technoblogy/i2c-sd-card-module/README.md

# I2C SD-Card Module

An SD-card module based on an ATtiny1614 that allows you to write to and read from files on an SD card using a two-wire I2C interface.

For more information see [I2C SD-Card Module](http://www.technoblogy.com/show?3XEP).
