technoblogy/i2c-sd-card-module/Eagle files/I2CSDCardModule.brd

## EAGLE design Eagle files/I2CSDCardModule.brd (2022-07-14)

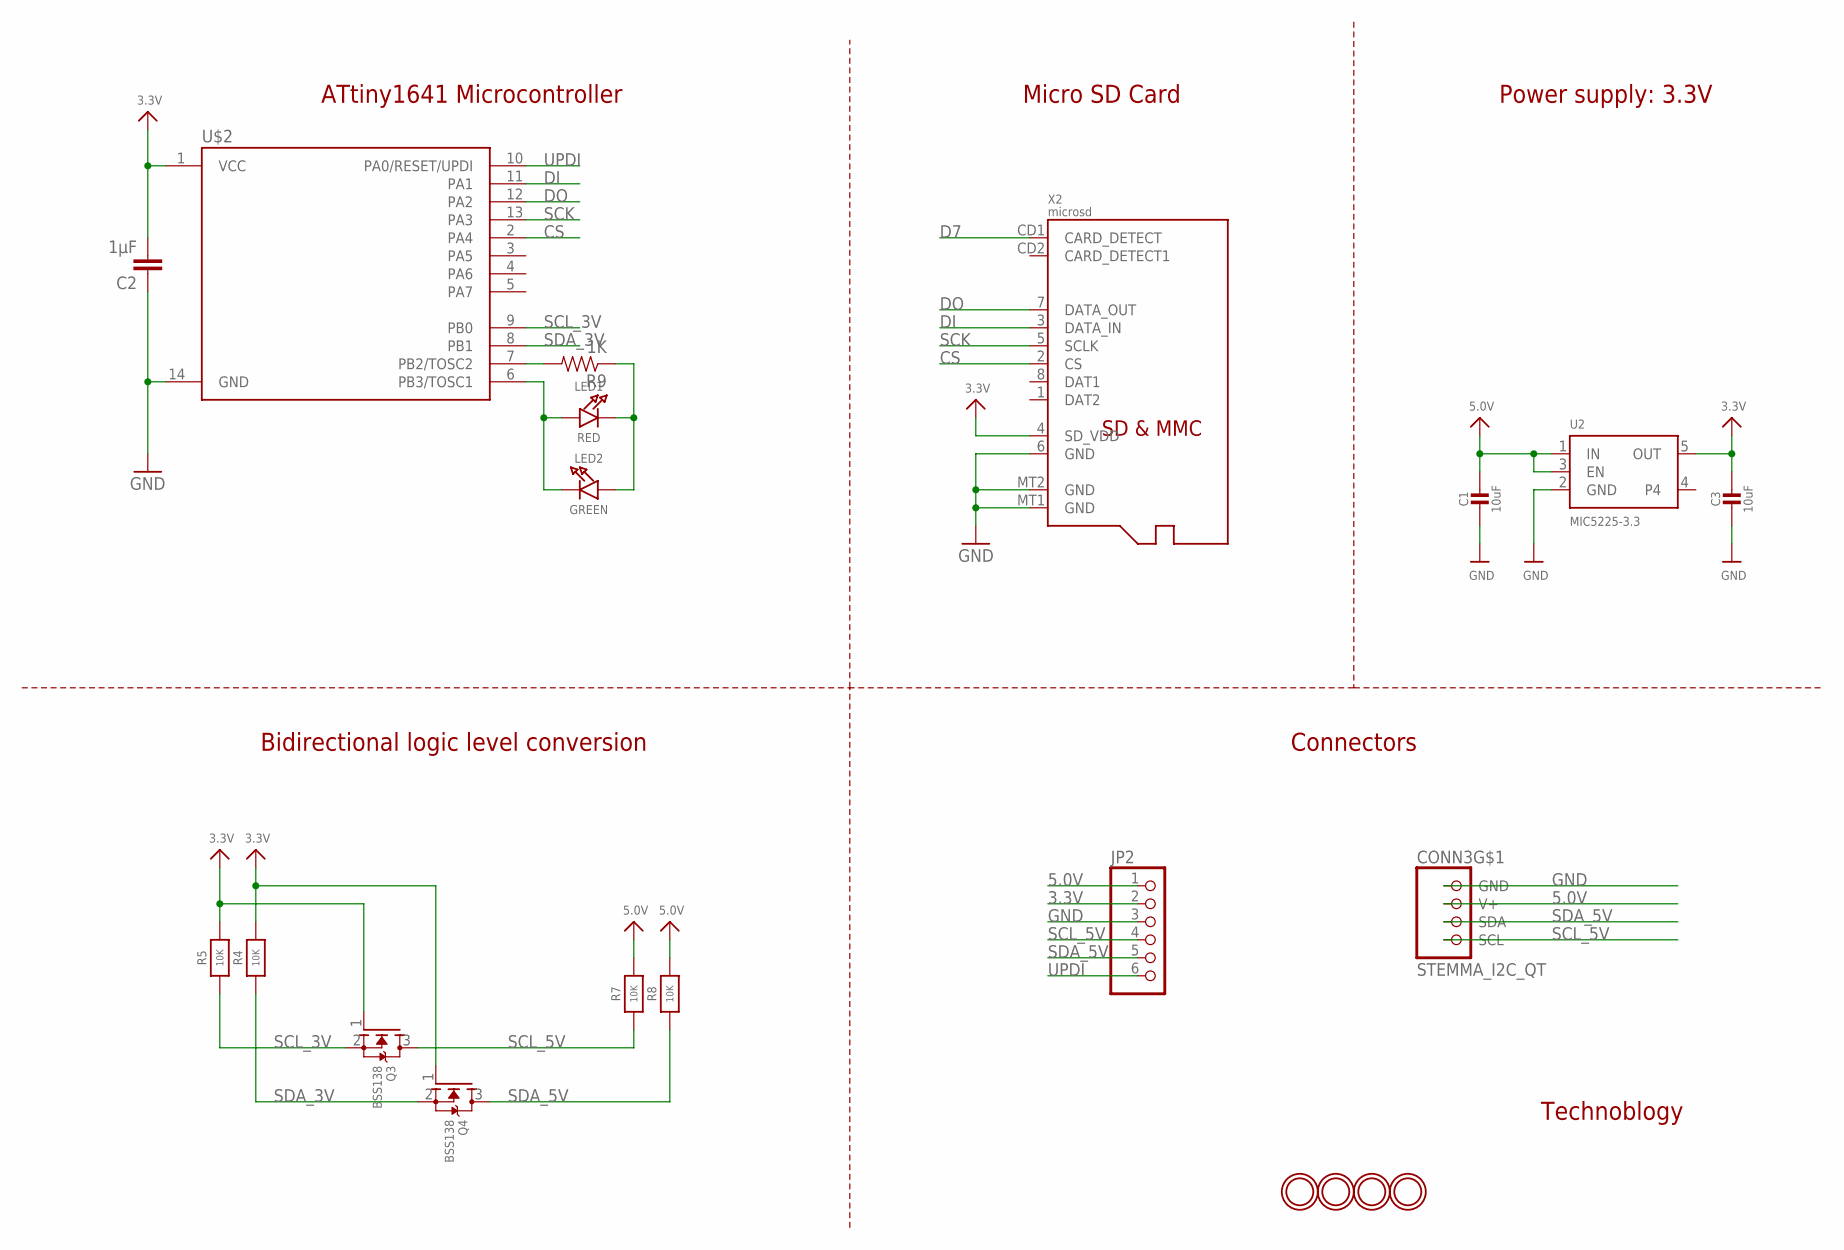
[picture p1: schematic I2CSDCardModule.sch]

Parts:
C1, C3: 10uF; 0805-NO
C2: 1µF; 0805
CONN3: STEMMA_I2C_QT; JST_SH4
JP2: HEADER-1X6ROUND; 1X06_ROUND
LED1: RED; CHIPLED_0805_NOOUTLINE
LED2: GREEN; CHIPLED_0805_NOOUTLINE
Q3, Q4: BSS138; SOT23-WIDE
R4, R5, R7, R8: 10K; 0805-NO
R9: 1K; 0805
U2: MIC5225-3.3; SOT23-5
U$1, U$5, U$6, U$9: MOUNTINGHOLE2.5; MOUNTINGHOLE_2.5_PLATED
U$2: ATTINY414; SO14
X2: microsd; MICROSD

Connections:
3.3V: C2.2, C3.1, JP2.2, Q3.1 (G), Q4.1 (G), R4.2, R5.2, U2.5 (OUT), U$2.1 (VCC), X2.4 (SD_VDD)
5.0V: C1.1, CONN3.2 (V+), JP2.1, R7.2, R8.2, U2.1 (IN), U2.3 (EN)
CS: U$2.2 (PA4), X2.2 (CS)
D7: X2.CD1 (CARD_DETECT)
DI: U$2.11 (PA1), X2.3 (DATA_IN)
DO: U$2.12 (PA2), X2.7 (DATA_OUT)
GND: C1.2, C2.1, C3.2, CONN3.1 (GND), JP2.3, U2.2 (GND), U$2.14 (GND), X2.6 (GND), X2.MT1 (GND), X2.MT2 (GND)
unnamed: LED1.A, LED2.C, U$2.6 (PB3/TOSC1)
unnamed: LED1.C, LED2.A, R9.1
unnamed: R9.2, U$2.7 (PB2/TOSC2)
SCK: U$2.13 (PA3), X2.5 (SCLK)
SCL_3V: Q3.2 (S), R5.1, U$2.9 (PB0)
SCL_5V: CONN3.4 (SCL), JP2.4, Q3.3 (D), R7.1
SDA_3V: Q4.2 (S), R4.1, U$2.8 (PB1)
SDA_5V: CONN3.3 (SDA), JP2.5, Q4.3 (D), R8.1
UPDI: JP2.6, U$2.10 (PA0/RESET/UPDI)

Notes on the sheet:
Power supply: 3.3V
ATtiny1641 Microcontroller
Technoblogy
Bidirectional logic level conversion
Micro SD Card
Connectors

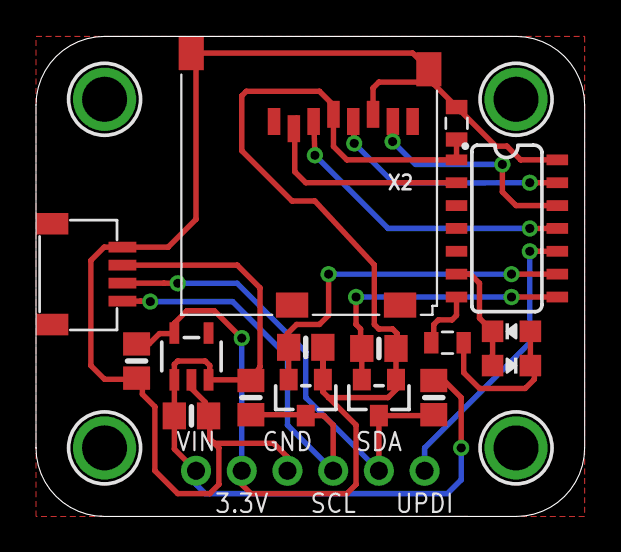
[picture p2: board I2CSDCardModule.brd from above]

Board: 2 copper layers, 30.5 x 26.7 mm, 21 parts (0 on the bottom side), 15 nets.
