technoblogy/i2c-sd-card-module/(commit log)

2022-07-14 Eagle files
    [I2CSDCardModule.brd, I2CSDCardModule.sch]
2025-09-13 Added ESP32 compatibility demo
